borti4938/n64rgb_flex/pcb/n64rgb_v3.prod.kicad_pcb

## KiCad design pcb/n64rgb_v3.prod.kicad_pcb (2025-01-15)

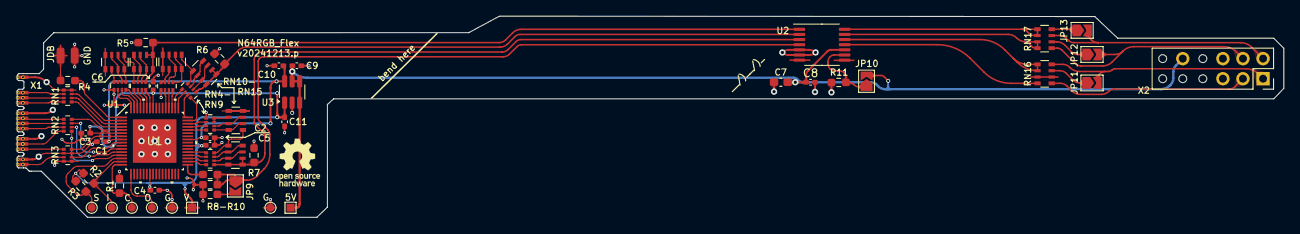
[picture p3: board n64rgb_v3.prod.kicad_pcb from above]

Board: 2 copper layers, 160.3 x 25.5 mm, 59 parts (0 on the bottom side), 88 nets.

Parts:
C1, C2, C3, C4, C5, C6, C8: 0.1u; C_0402_1005Metric_Pad0.74x0.62mm_HandSolder
C7: 22u; C_0603_1608Metric_Pad1.08x0.95mm_HandSolder
C9, C10, C11: 1u; C_0402_1005Metric_Pad0.74x0.62mm_HandSolder
J1, J9: Conn_01x01_Male; TestPoint_Pad_1.0x1.0mm
J2, J3, J4, J5, J6, J10: Conn_01x01_Male; TestPoint_Pad_D1.0mm
J7: OS202011MS2QS1; SolderWirePad_1x01_SMD_1x2mm
J8: Conn_01x01_Male; SolderWirePad_1x01_SMD_1x2mm
JP9, JP10, JP11, JP12, JP13: SolderJumper_2_Open; SolderJumper-2_P1.3mm_Open_TrianglePad1.0x1.5mm
R1: 1k; R_0603_1608Metric_Pad0.98x0.95mm_HandSolder
R2, R3: 10k; R_0603_1608Metric_Pad0.98x0.95mm_HandSolder
R4, R5, R6, R7: 280; R_0603_1608Metric_Pad0.98x0.95mm_HandSolder
R8, R11: 4k7; R_0603_1608Metric_Pad0.98x0.95mm_HandSolder
R9: 6k19; R_0603_1608Metric_Pad0.98x0.95mm_HandSolder
R10: 523; R_0603_1608Metric_Pad0.98x0.95mm_HandSolder
RN1, RN2, RN3: BLA2ABB121SN4D; R_Array_Convex_4x0402
RN4, RN5, RN6, RN7, RN8, RN9: EXB-28V202JX; R_Array_Convex_4x0402
RN10, RN11, RN12, RN13, RN14, RN15: EXB-38V102JV; R_Array_Convex_4x0603
RN16, RN17: YC164-FR-0775RL; R_Array_Convex_4x0603
U1: 5M80ZE64/5M160ZE64; EQFP64P_A1P2-D4P5_INT
U2: ths7374; TSSOP-14_4.4x5mm_P0.65mm
U3: AP7312-1833W6-7; SOT-23-6_Handsoldering
X1: n64_rcp_vid_out_no_3v3_con; Connector_RCP_Video_Interface_no_3V3
X2: multiout_pads; SNES_MultiOut_RGBS_5V_GND

Connections:
#DSYNC: RN3.8 (R1.2), U1.7 (IO/CLK0)
/B: JP12.2 (B), RN17.5 (R4.2), X2.4 (Blue)
/B': RN17.3 (R3.1), RN17.4 (R4.1), U2.13 (Ch2.out)
/B_dac: R6.1, RN7.5 (R4.2), RN13.4 (R4.1), RN13.5 (R4.2), RN13.6 (R3.2), U2.2 (Ch2.in)
/D0_i: RN1.2 (R2.1), X1.25 (D0)
/D1_i: RN1.3 (R3.1), X1.24 (D1)
/D2_i: RN1.4 (R4.1), X1.23 (D2)
/D3_i: RN2.1 (R1.1), X1.20 (D3)
/D4_i: RN2.2 (R2.1), X1.19 (D4)
/D5_i: RN2.3 (R3.1), X1.18 (D5)
/D6_i: RN2.4 (R4.1), X1.15 (D6)
/Fil.byp.: JP10.1 (A), R11.2, U2.9 (Fil.byp.)
/G: JP13.2 (B), RN17.7 (R2.2), X2.2 (Green)
/G': RN17.1 (R1.1), RN17.2 (R2.1), U2.14 (Ch1.out)
/G_dac: R5.1, RN5.5 (R4.2), RN11.4 (R4.1), RN11.5 (R4.2), RN11.6 (R3.2), U2.1 (Ch1.in)
/R: JP11.2 (B), RN16.8 (R1.2), X2.1 (Red)
/R': RN16.1 (R1.1), RN16.2 (R2.1), U2.12 (Ch3.out)
/R_dac: R7.1, RN9.5 (R4.2), RN15.4 (R4.1), RN15.5 (R4.2), RN15.6 (R3.2), U2.3 (Ch3.in)
/S: RN16.5 (R4.2), X2.3 (Sync)
/S': RN16.4 (R4.1), U2.11 (Ch4.out)
/S_dac: JP9.1 (A), R8.2, R9.1, U2.4 (Ch4.in)
/VCLK_i: RN3.3 (R3.1), X1.11 (VCLK)
/nDSYNC_i: RN3.1 (R1.1), X1.14 (nDSYNC)
/nViDeBlur_i: J7.1, R4.1
B0: RN6.2 (R2.1), U1.53 (DIFFIO_T5p)
B1: RN6.3 (R3.1), U1.52 (DIFFIO_T5n)
B2: RN6.4 (R4.1), U1.51 (IO)
B3: RN7.1 (R1.1), U1.50 (DIFFIO_T6p)
B4: RN7.2 (R2.1), U1.49 (DIFFIO_T6n)
B5: RN7.3 (R3.1), U1.48 (IO)
B6: RN7.4 (R4.1), U1.47 (DIFFIO_R1p)
CSYNC_o: R8.1, U1.33 (DIFFIO_B7n)
D0: RN1.7 (R2.2), U1.2 (IO)
D1: RN1.6 (R3.2), U1.3 (DIFFIO_L2p)
D2: RN1.5 (R4.2), U1.4 (DIFFIO_L2n)
D3: RN2.8 (R1.2), U1.5 (IO)
D4: RN2.7 (R2.2), U1.11 (IO)
D5: RN2.6 (R3.2), U1.12 (IO)
D6: RN2.5 (R4.2), U1.13 (IO)
G0: RN4.2 (R2.1), U1.64 (DIFFIO_L1p)
G1: RN4.3 (R3.1), U1.63 (DIFFIO_T1p)
G2: RN4.4 (R4.1), U1.62 (IO)
G3: RN5.1 (R1.1), U1.61 (DIFFIO_T1n)
G4: RN5.2 (R2.1), U1.60 (DIFFIO_T2p)
G5: RN5.3 (R3.1), U1.59 (DIFFIO_T2n)
G6: RN5.4 (R4.1), U1.58 (DIFFIO_T3p)
GND: C1.2, C2.2, C3.2, C4.2, C5.2, C6.2, C7.2, C8.2, C9.2, C10.2, C11.2, J2.1, J8.1, J10.1, R1.1, R5.2, R6.2, R7.2, R9.2, R10.2, R11.1, RN1.1 (R1.1), RN1.8 (R1.2), RN3.2 (R2.1), RN3.4 (R4.1), RN3.5 (R4.2), RN3.7 (R2.2), RN4.1 (R1.1), RN6.1 (R1.1), RN8.1 (R1.1), U1.EPAD (GROUND), U2.5 (GND), U2.6 (Disable), U3.2 (GND), X1.12 (GND), X1.16 (GND), X1.21 (GND), X1.28 (GND), X2.5 (GND), X2.6 (GND)
unnamed: JP9.2 (B), R10.1
unnamed: JP11.1 (A), RN16.7 (R2.2)
unnamed: JP12.1 (A), RN17.6 (R3.2)
unnamed: JP13.1 (A), RN17.8 (R1.2)
unnamed: RN10.1 (R1.1), RN10.8 (R1.2)
unnamed: RN4.7 (R2.2), RN4.8 (R1.2), RN10.2 (R2.1)
unnamed: RN4.6 (R3.2), RN10.3 (R3.1), RN10.7 (R2.2)
unnamed: RN4.5 (R4.2), RN10.4 (R4.1), RN10.6 (R3.2)
unnamed: RN5.8 (R1.2), RN10.5 (R4.2), RN11.1 (R1.1)
unnamed: RN5.7 (R2.2), RN11.2 (R2.1), RN11.8 (R1.2)
unnamed: RN5.6 (R3.2), RN11.3 (R3.1), RN11.7 (R2.2)
unnamed: RN12.1 (R1.1), RN12.8 (R1.2)
unnamed: RN6.7 (R2.2), RN6.8 (R1.2), RN12.2 (R2.1)
unnamed: RN6.6 (R3.2), RN12.3 (R3.1), RN12.7 (R2.2)
unnamed: RN6.5 (R4.2), RN12.4 (R4.1), RN12.6 (R3.2)
unnamed: RN7.8 (R1.2), RN12.5 (R4.2), RN13.1 (R1.1)
unnamed: RN7.7 (R2.2), RN13.2 (R2.1), RN13.8 (R1.2)
unnamed: RN7.6 (R3.2), RN13.3 (R3.1), RN13.7 (R2.2)
unnamed: RN14.1 (R1.1), RN14.8 (R1.2)
unnamed: RN8.7 (R2.2), RN8.8 (R1.2), RN14.2 (R2.1)
unnamed: RN8.6 (R3.2), RN14.3 (R3.1), RN14.7 (R2.2)
unnamed: RN8.5 (R4.2), RN14.4 (R4.1), RN14.6 (R3.2)
unnamed: RN9.8 (R1.2), RN14.5 (R4.2), RN15.1 (R1.1)
unnamed: RN9.7 (R2.2), RN15.2 (R2.1), RN15.8 (R1.2)
unnamed: RN9.6 (R3.2), RN15.3 (R3.1), RN15.7 (R2.2)
R0: RN8.2 (R2.1), U1.46 (DIFFIO_R1n)
R1: RN8.3 (R3.1), U1.45 (IO)
R2: RN8.4 (R4.1), U1.44 (DIFFIO_R2p)
R3: RN9.1 (R1.1), U1.37 (DIFFIO_R3p)
R4: RN9.2 (R2.1), U1.36 (DIFFIO_R3n)
R5: RN9.3 (R3.1), U1.35 (DIFFIO_R4p)
R6: RN9.4 (R4.1), U1.34 (DIFFIO_R4n)
TCK: J3.1, R1.2, U1.16 (TCK)
TDI: J5.1, R2.2, U1.15 (TDI)
TDO: J4.1, U1.17 (TDO)
TMS: J6.1, R3.2, U1.14 (TMS)
VCC: C7.1, C8.1, C9.1, J9.1, JP10.2 (B), U2.10 (Vcc), U3.3 (EN2), U3.4 (EN1), U3.5 (IN), X2.10 (5V)
VCCINT: C1.1, C2.1, C10.1, U1.8 (VCCINT), U1.41 (VCCINT), U3.6 (OUT1)
VCLK: RN3.6 (R3.2), U1.9 (IO/CLK1)
VDD: C3.1, C4.1, C5.1, C6.1, C11.1, J1.1, R2.1, R3.1, U1.6 (VCCIO1), U1.23 (VCCIO1), U1.39 (VCCIO2), U1.57 (VCCIO2), U3.1 (OUT2)
nViDeBlur: R4.2, U1.1 (DIFFIO_L1n)
