borti4938/n64rgb_flex/(notices)

Notices in the files:
pcb/n64rgb_v3.prod.kicad_pcb:
Copyright 2022 - 2025 (c) Peter Bartmann
pcb/n64rgb_v3.kicad_pcb:
Copyright 2022 (c) Peter Bartmann
